SimpleAstronaut/Agent-Light/hardware/eda/PCB-Layout-RevA.md

# Agent Light Rev A PCB 布局布线初版

日期：2026-10-27。编辑器：嘉立创 EDA 专业版 4.1.78。

## 交付

- `Agent-Light-v1-layout.epro2`：包含五页原理图、依赖库和完成布局布线的 PCB1；导入嘉立创 EDA 专业版打开。
- `sources/PCB1.epcb`：PCB 原生文本源码备份，依赖库在工程包内。
- `previews/pcb-layout-final.png`：编辑器实际画布预览。
- `Agent-Light-RevA-DRAFT-Gerber.zip`：EDA 导出的制造初稿，含上下铜、丝印、阻焊、钢网、板框和钻孔。
- `Agent-Light-RevA-PickPlace-All.tsv`：EDA 原始坐标导出，包含所有 35 个位号。
- `Agent-Light-RevA-Assembly-PickPlace.csv`：装配坐标，排除 C3、R6 以及 TP1–TP8，共 25 个器件；搭配既有 BOM-RevA.csv 使用。
- `pcb-verification.json`：最终 PCB DRC 和图元数量记录。

## 实施结果

12 × 40 mm 双层板；顶层装配。USB-C 位于下端，红灯在上、黄灯在中、绿灯在下。35 个器件全部保留，包括 2 个 DNP 选配器件和 8 个不装排针的镀通孔测试焊盘。

ESD 位于接口之后，USB 串阻位于 MCU 前方。USB 主链路位于顶层；USB-C 重复 D− 焊盘连接采用 2 个过孔跨越，避免与重复 D+ 连接短接。其余电源、LED、复位、BOOT 和 SWD 网络均已连接。顶底层均有 GND 覆铜，已重建填充；局部接地补充过孔。保留原理图默认 R5 装配、R6/C3 不装规则。

最终编辑器 PCB DRC（严格模式）返回 `[]`：零报告错误、零未连接。最终统计：35 个器件、305 段直线走线、32 个过孔、2 个覆铜边框。Gerber 钻孔表最小孔径约 0.305 mm。

## 制造前必须解决的项目

**此版本是布局布线初版，制造包明确标记 DRAFT；尚未达到计划 WP31 的全部制造冻结要求。**

1. 板厚、板厂实际层叠和介电参数尚未冻结，USB 使用初版布线尺寸，未证明达到 90 Ω 差分阻抗，也未完成基于真实层叠的差分耦合/匹配优化。DRC 通过不代表阻抗通过。应在冻结层叠后调整 USB 几何并重新导出制造包。
2. USB-C 重复 D− 焊盘跨层，须纳入 USB 回流及信号完整性复核。底层亦有部分信号走线，地铜不是无切割的完整平面。
3. 部分局部接地过孔位于或接近 SMD 焊盘。首版手焊时控制焊料；如计划钢网回流装配，应先复核吸锡风险和塞孔/移孔方案。
4. 丝印已缩小，但密集区域仍需结合装配图查看位号。外壳遮光仓、USB-C 插拔空间和工装测试点可达性尚无结构模型验证。
5. 尚未执行第二人封装/极性审查、板厂 DFM、实物 bring-up、USB 枚举/热插拔或 ESD 测试；这些不在本次软件 DRC 的证明范围。

## USB 网络长度记录

以下为 EDA 各网络总走线长度，含连接器重复焊盘的分支，不等同于端到端差分路径长度。

| 网络 | mil |
|---|---:|
| USB_DP_CON | 293.957318 |
| USB_DM_CON | 358.253209 |
| USB_DP_ESD | 196.968934 |
| USB_DM_ESD | 96.194703 |
| USB_DP | 165.511008 |
| USB_DM | 173.534304 |

没有下单或上传制造资料到板厂。
