SimpleAstronaut/Agent-Light/shell/revision-2026-11-12/设计与检查记录.md

# Rev B 外壳设计与执行记录

用户已确认方案：打印底壳，Type-C 向上敞开 U 槽，PCB 从上方落入，透明亚克力平贴胶粘。

现有模型：44×16×13 mm，主腔40×12 mm，顶部定位唇内口42×14 mm；PCB STEP板框约39.975×11.975×1.600 mm，USB外伸1.367 mm。原装配体没有PCB实体。

方案比较：只放大内腔仍要求USB斜插；采用U槽消除侧孔上桥，便于垂直装配（用户选定）；重新拆分侧墙增加零件和接缝，本次不采用。

实施尺寸由设计者选取：内腔41.2×13.2 mm（每边约0.6 mm余量），外形保留44×16×13 mm；U槽宽11 mm，从既有孔底接通至顶；支撑横筋中部下凹1 mm保留两侧支承；透明板44×16×2 mm，平贴顶沿。胶层暂按0.15 mm装配示意，实际厚度及材料由加工试片确认。

执行计划：
- [x] 复制所有原始模型到revision-2026-11-12，另存底壳-RevB。
- [x] 在原生副本追加内腔扩容、USB敞口、焊点避让特征，导出STEP/STL。
- [x] 建立亚克力盖模型与1:1 DXF，制作含PCB的独立检查装配。
- [x] 以精确几何检查原始/修改壳的静态干涉与垂直装配路径，保存结果。
- [x] 检查文件存在、重新读回几何有效性、原始文件哈希不变，交付说明。

验证边界：STEP不包含手焊焊料；不能用数字干涉通过代替实物试装；未指定打印材料、设备、实板外形测量和胶水，留作样件验证事项。不改PCB，不下单。
