SimpleAstronaut/Agent-Light/docs/superpowers/plans/2026-10-28-firmware.md

# Agent Light FreeRTOS Firmware Implementation Plan

> **For agentic workers:** Use superpowers:executing-plans to implement this plan task-by-task. Steps use checkbox syntax for tracking.

**Goal:** 为已完成的 STM32F042F6P6 Rev A PCB 实现可构建、可测试的 FreeRTOS USB CDC 固件。

**Architecture:** PC 是业务状态唯一权威。固件使用静态 FreeRTOS 任务和缓冲，USB ISR 仅处理 USB 栈和收发队列；单任务管理协议、显示和链路超时，避免共享状态竞争。

**Tech Stack:** C11、STM32CubeF0 HAL/USB、FreeRTOS、ARM GCC；提供 MDK 工程与 CubeMX 配置说明。

**Spec:** outputs/agent-indicator-execution-plan.md §8、§15；hardware/eda/README.md。

## Global Constraints

- STM32F042F6P6，Flash 32 KB、RAM 6 KB。
- PA9/PA10 重映射 USB PA11/PA12；HSI48 + CRS；PA0/1/2 AF2 TIM2_CH1/2/3，10 kHz。
- 协议 v1、payload ≤32、COBS + CRC16-CCITT-FALSE、20–100% 亮度、默认 35%、5 秒看门狗。
- 中文注释；采用 Google C++ 指南中适用 C 的命名、缩进、头文件防护和函数契约说明，厂商文件不改风格。
- 仅 SWD；不写配置 Flash。实物验收和 Cube/Keil GUI 首次确认仍按原计划交给用户。

## Review Focus

- USB 分包/粘包/队列溢出后的完整帧恢复。
- 同 seq 不同请求、重试和 revision 回绕。
- 超时后重试同 revision 必须重新进入 ACTIVE；心跳不能恢复旧灯态。
- USB reset/suspend/resume 与待发送 ACK 的代次隔离。
- RAM/任务栈/USB 分配、ISR 和调度器启动顺序。

### Task 1: 协议和显示核心

**Files:** firmware/app/{crc16,cobs,display,protocol}.c/.h；firmware/tests/host/test_main.c。
**Interfaces:** ProtocolFeed / ProtocolReset / ProtocolPoll / DisplayGetLeds；核心不依赖 HAL/RTOS。

- [x] 写主机测试，观察缺少实现时失败。
- [x] 实现帧校验、NACK、单事务去重、revision、模式和灯效。
- [x] gcc 严格警告构建并通过测试；补独立 Python golden vectors。

### Task 2: 板级和 FreeRTOS USB 集成

**Files:** firmware/Core、firmware/USB_Device、firmware/app/app_main.c、firmware/build.ps1、链接脚本。
**Interfaces:** USB RX 有界队列；SerialTx 单一发送入口；AppUsbEvent 使总线事件先于字节处理。

- [x] 固定 STM32CubeF0 官方 tag 和子模块 SHA，记录工具链。
- [x] 接入静态任务、10 kHz PWM、HSI48/CRS、USB CDC、静态 USB 类存储。
- [x] 构建 Debug/Release，检查 map 和栈预算，输出 ELF/HEX/BIN/hash。

### Task 3: 工程和验收交付

**Files:** firmware/README.md、firmware/docs、firmware/MDK-ARM、contracts/usb-protocol-v1.md、firmware/tools。

- [x] 提供精确 CubeMX 配置、MDK 工程、版本表和 SWD/HIL 步骤。
- [x] 执行完整主机测试、两个目标配置构建和独立审查。
- [x] 记录实测结果和未执行的 GUI/硬件门禁。

## 执行记录

- 目录不是 Git 仓库，直接在用户指定目录新增 firmware/、contracts/ 和文档，不移动硬件文件，不创建额外 worktree。
- 用户已授权按现有设计和计划开发；以上是 WP30 的执行拆分，直接推进。
- 完成：主机核心及真实Setup入口测试通过，17组向量一致；最终Debug/Release Flash24324/20044B，静态RAM5356/5344B，MSP784/800B。产物一致性和中断向量校验通过。
- 独立审查发现CDC控制请求越界和配置前空指针路径，修复后追加入口级回归；另修复PWM重复启动和USB供电描述符。
- 未执行：Keil首次GUI构建、SWD烧录、实际USB/电气/长稳。仅找到蓝牙串口。详见firmware/docs/verification.md，不将这些标为通过。
