SimpleAstronaut/Agent-Light/docs/superpowers/plans/2026-11-06-pc-dsh.md

# PC + DSH implementation plan

Goal: implement the approved local HTTP → SQLite FSM → USB service and DSH Host observer with durable worker reporting, using the November 6 design and frozen USB v1.

Execution: inline in the supplied non-Git directory. User requests minimal review/testing: omit independent reviewers, repeated approval, broad performance/fault campaigns and commits. Preserve focused protocol/FSM/outbox checks and build checks.

- [x] Shared strict event schema, scoped producer/runtime/instance identity and source capability manifest.
- [x] Python PC service: transactional inbox/FSM/display, HTTP authentication, CLI configuration, process lock and single serial worker.
- [x] TypeScript plugin: version gate, root-only lifecycle, approval/question pairing, bounded reporter, durable outbox Worker.
- [x] Build, focused smoke checks, deployment overlay and operational documentation. Live DSH profile was not modified.

Verification limits: real Web answerer ordering, hardware E2E, kill-at-each-fsync and performance percentiles require separate evidence; capabilities remain unverified until then. No real Codex adapter is claimed.

Result: PC 5 focused checks pass, plugin 4 focused checks pass. Installed Cordis global/prepend probe passes. Synthetic root lifecycle through Cordis → durable Worker → real PC HTTP/SQLite reaches RUNNING → ATTENTION → COMPLETED. Python wheel and npm tarball are in outputs/packages. See outputs/pc-dsh-implementation.md for the delivery record.
