SimpleAstronaut/Agent-Light/hardware/eda/previews/contact-sheet.png

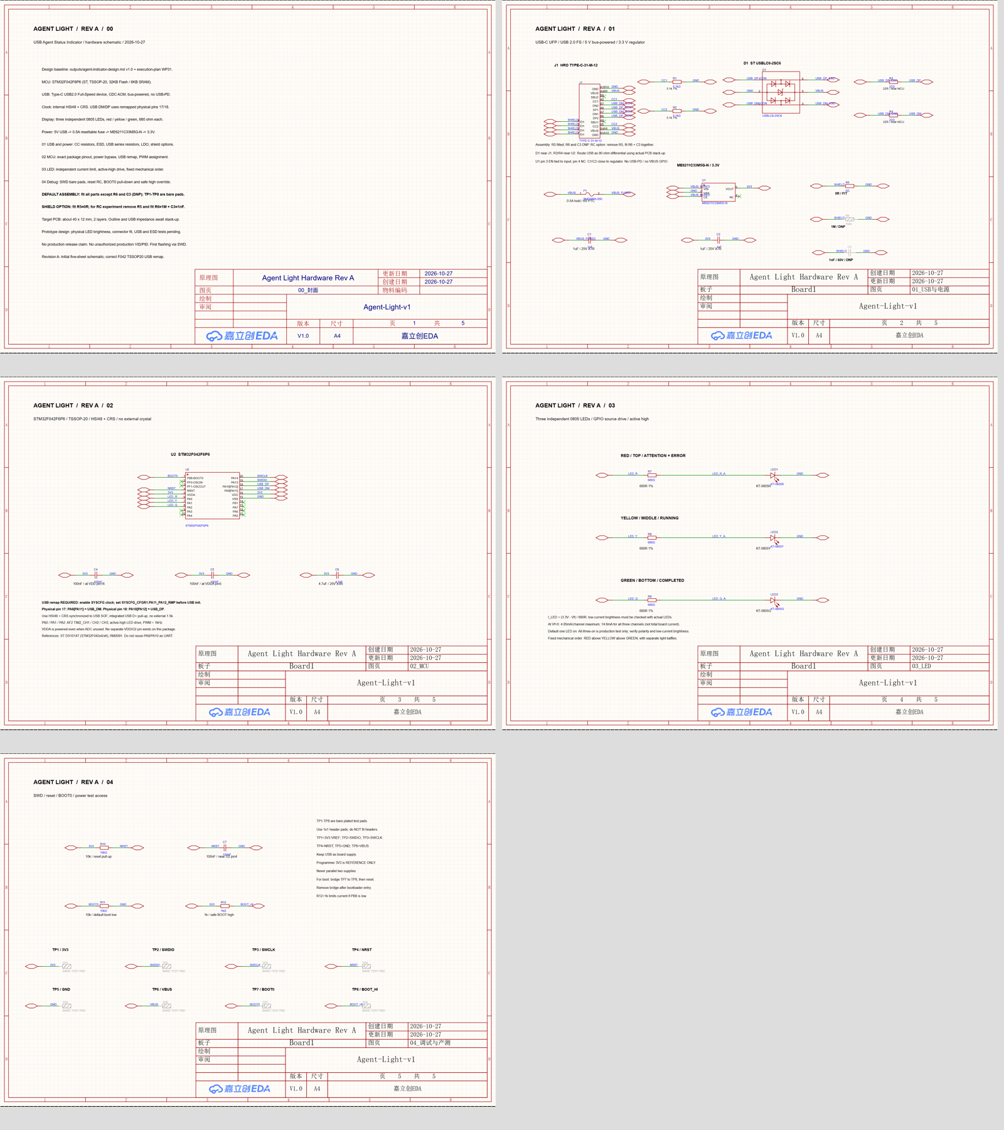
hardware/eda/previews/contact-sheet.png
