SimpleAstronaut/Agent-Light/hardware/eda/previews/pcb-layout-final.png

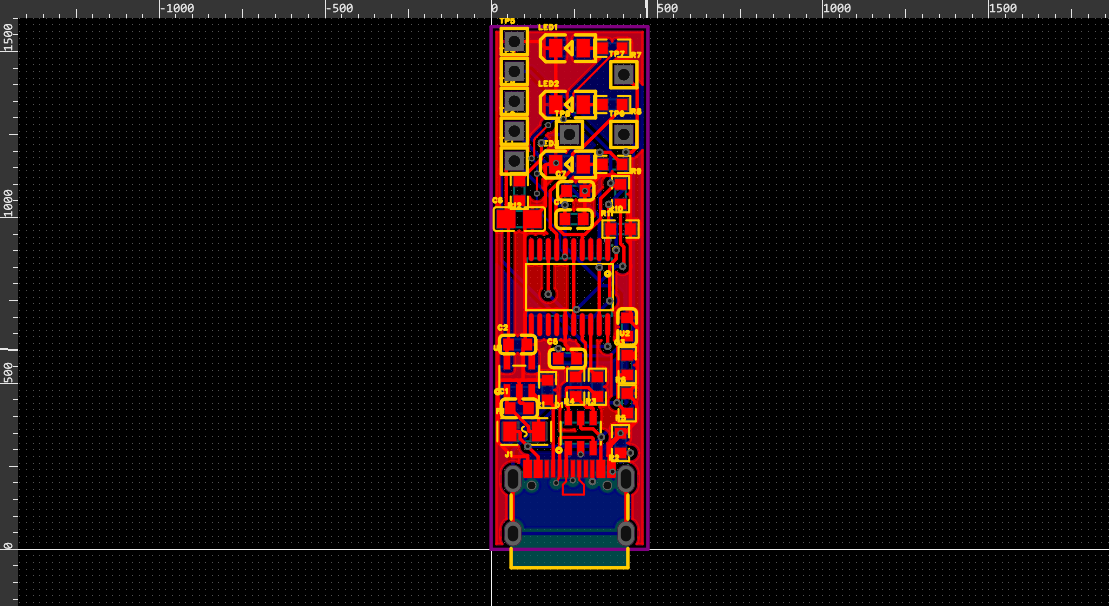
hardware/eda/previews/pcb-layout-final.png
