SimpleAstronaut/Agent-Light/hardware/eda/previews/SCH_Agent Light Hardware Rev A_1-00_封面_2026-10-27.png

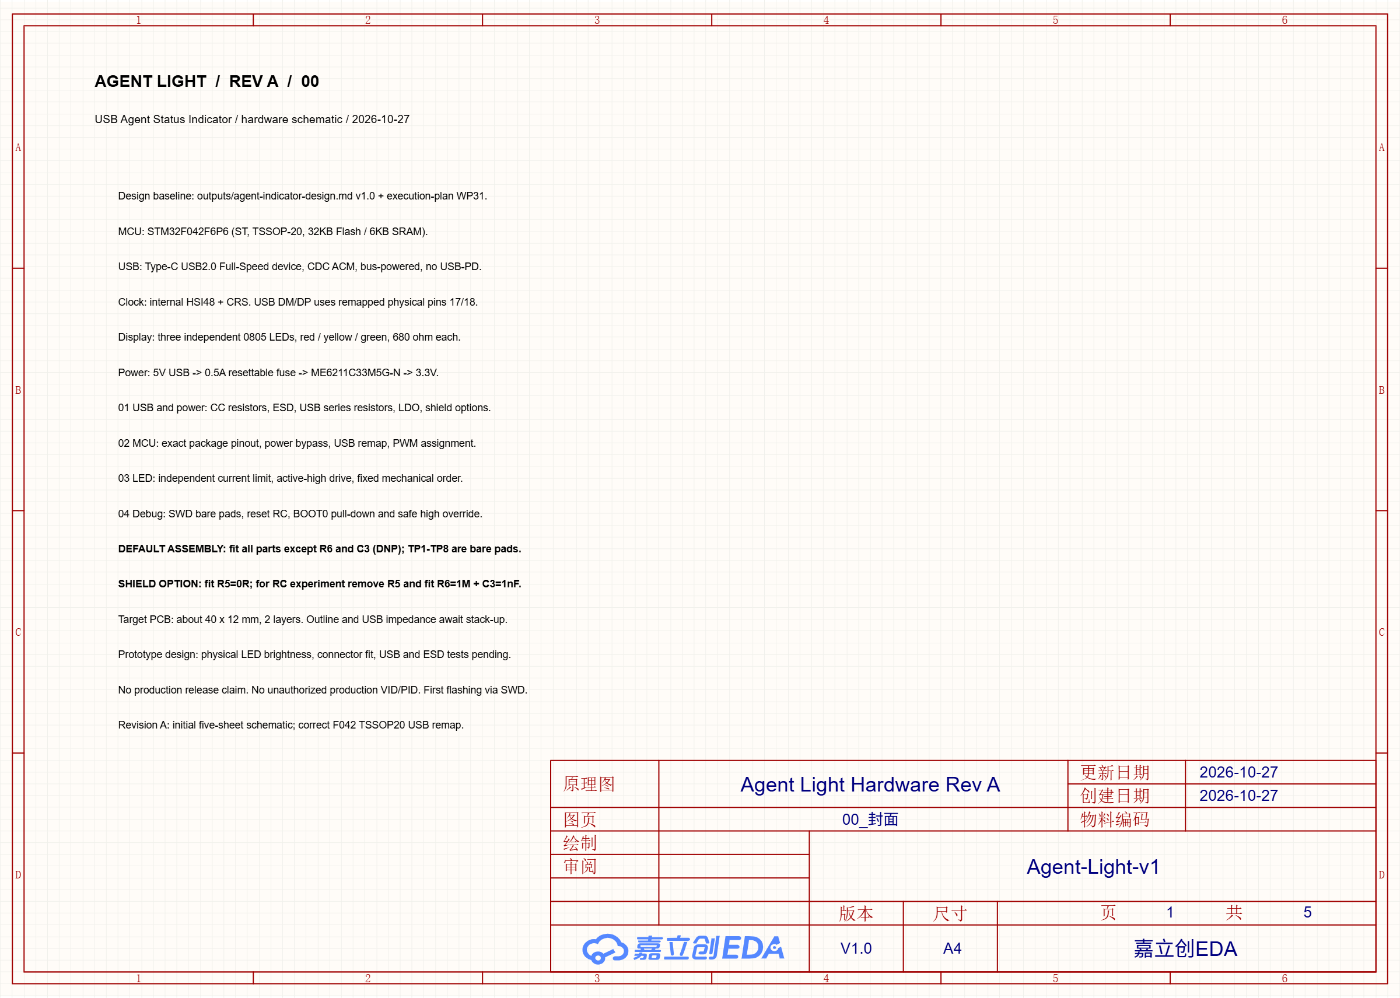
hardware/eda/previews/SCH_Agent Light Hardware Rev A_1-00_封面_2026-10-27.png
