SimpleAstronaut/Agent-Light/hardware/eda/previews/SCH_Agent Light Hardware Rev A_2-01_USB与电源_2026-10-27.png

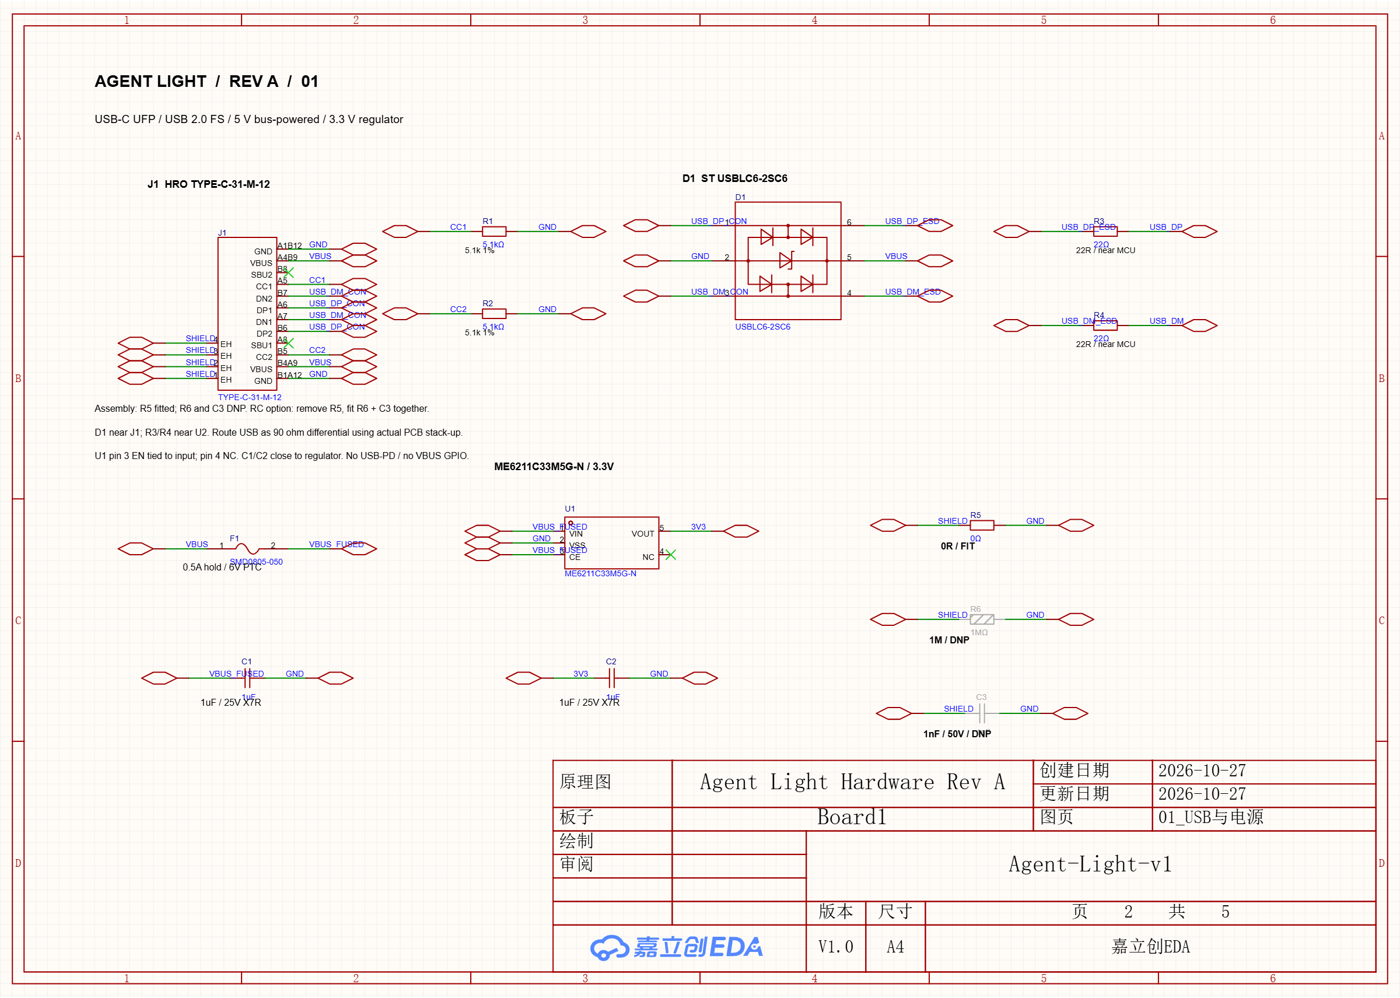
hardware/eda/previews/SCH_Agent Light Hardware Rev A_2-01_USB与电源_2026-10-27.png
