SimpleAstronaut/Agent-Light/hardware/eda/previews/SCH_Agent Light Hardware Rev A_3-02_MCU_2026-10-27.png

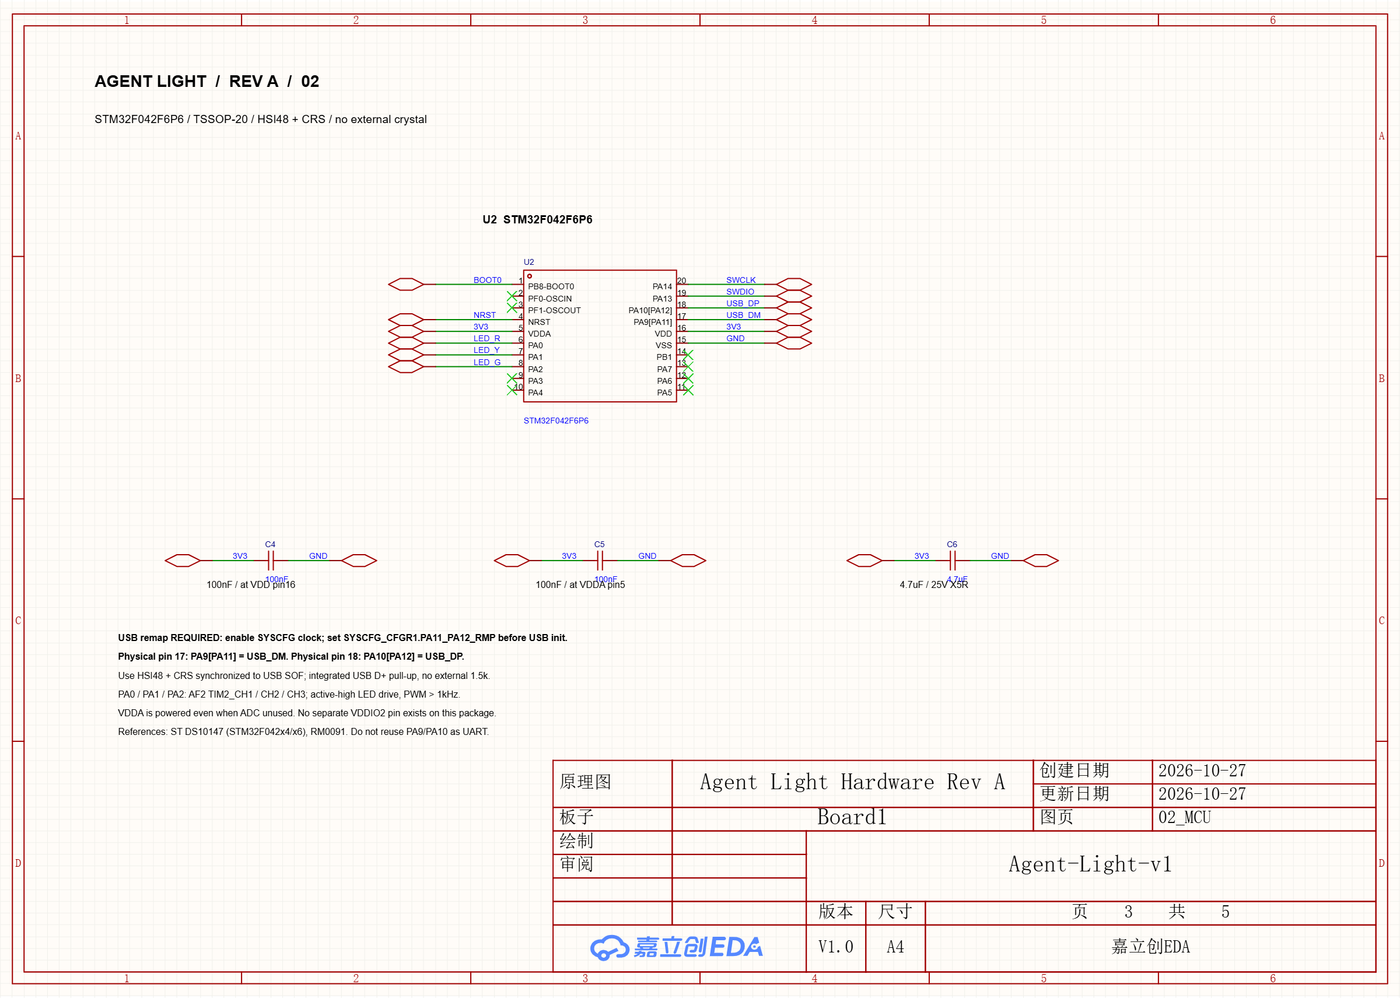
hardware/eda/previews/SCH_Agent Light Hardware Rev A_3-02_MCU_2026-10-27.png
