SimpleAstronaut/Agent-Light/hardware/eda/previews/SCH_Agent Light Hardware Rev A_4-03_LED_2026-10-27.png

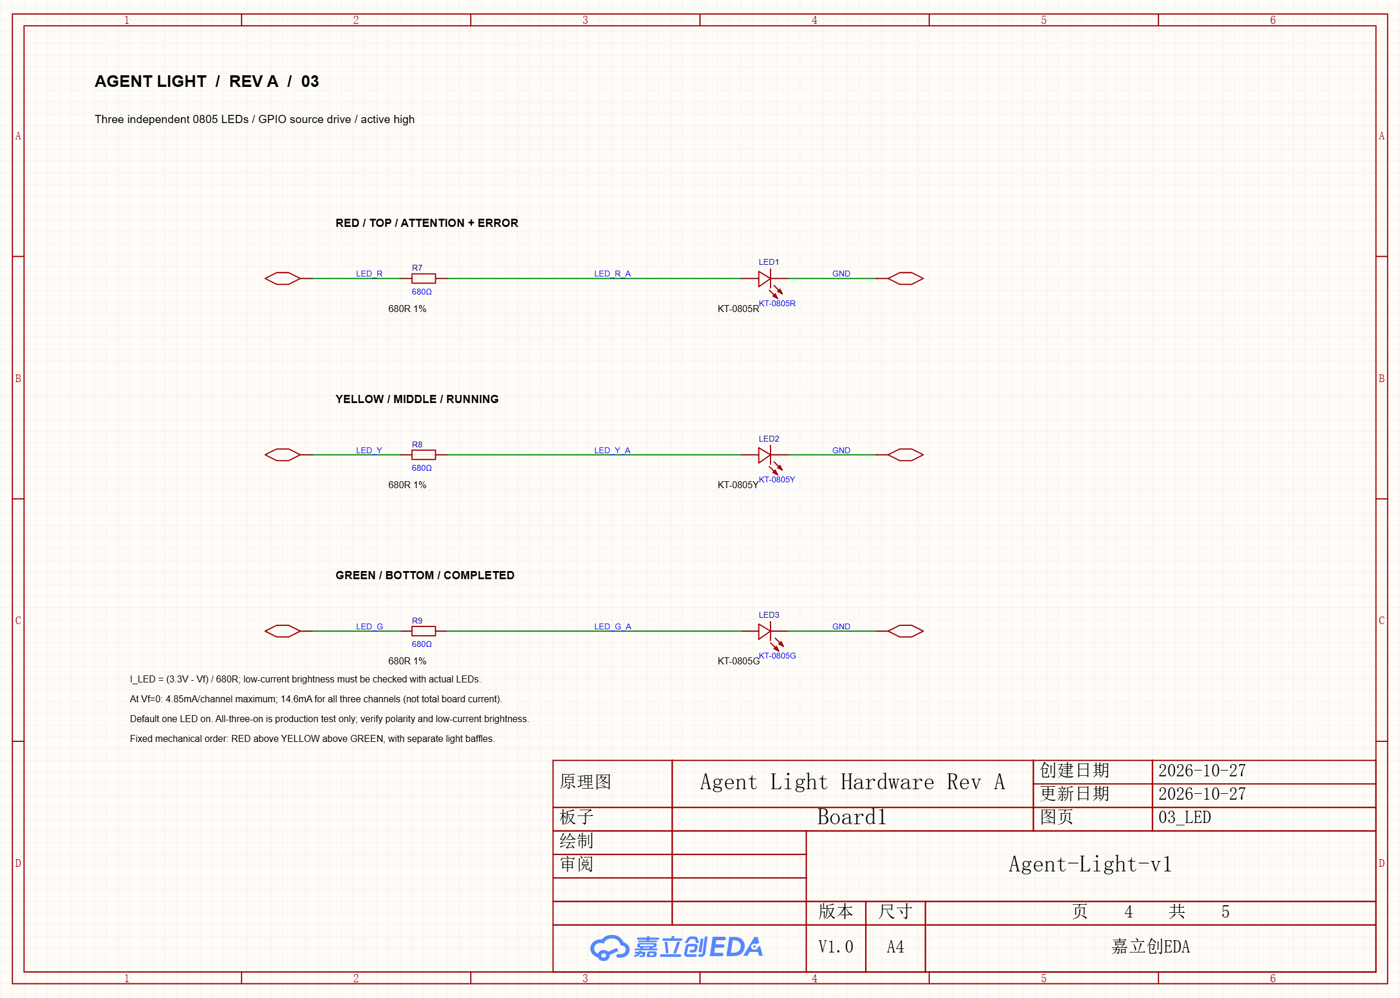
hardware/eda/previews/SCH_Agent Light Hardware Rev A_4-03_LED_2026-10-27.png
