SimpleAstronaut/Agent-Light/outputs/agent-integrations-dsh-preview.png

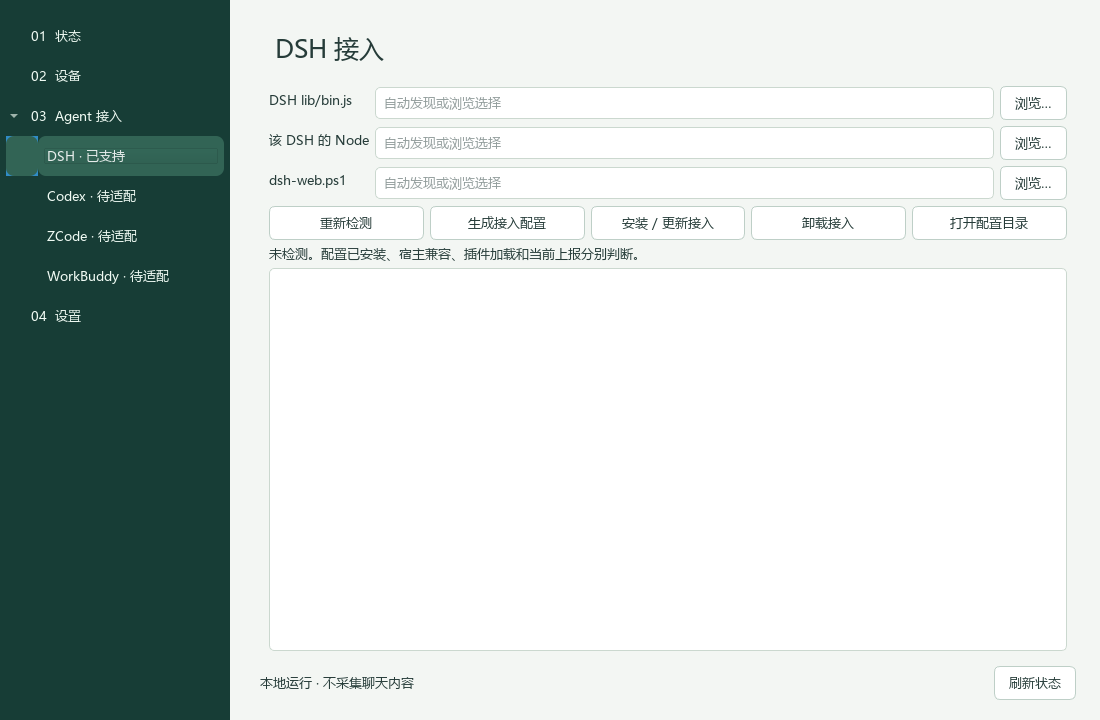
outputs/agent-integrations-dsh-preview.png
