SimpleAstronaut/Agent-Light/outputs/desktop-preview.png

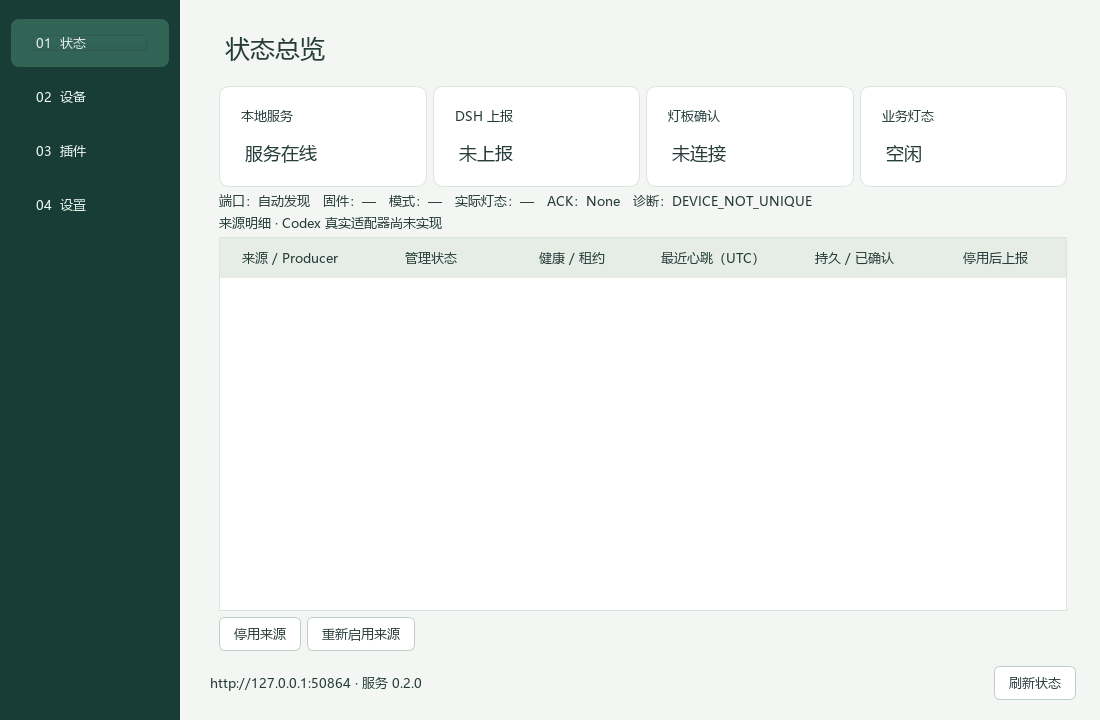
outputs/desktop-preview.png
