SimpleAstronaut/Agent-Light/shell/revision-2026-11-12/previews/RevB-open.png

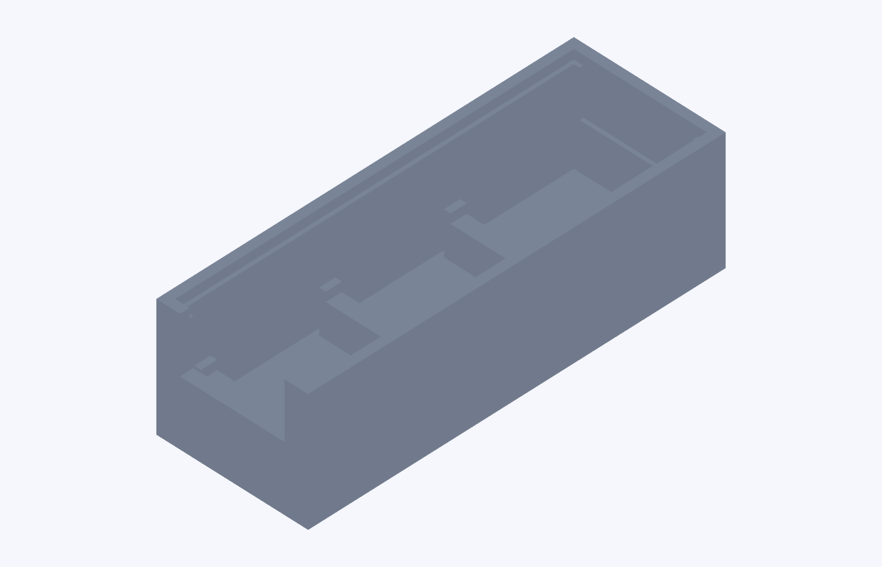
shell/revision-2026-11-12/previews/RevB-open.png
