SimpleAstronaut/Agent-Light/shell/revision-2026-11-12/零件1.STEP

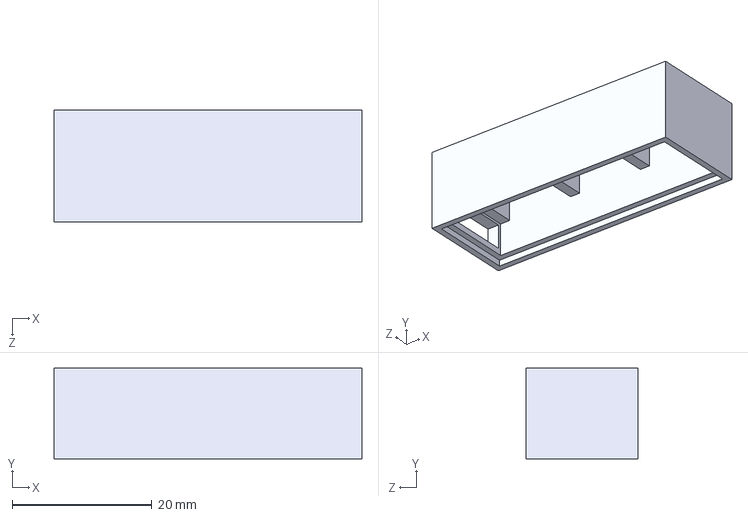
[picture p12: CAD file, 2026-11-12]
shell/revision-2026-11-12/零件1.STEP
44.0 x 13.0 x 16.0 mm
