SimpleAstronaut/Agent-Light/shell/revision-2026-11-12/底壳-RevB-调整坐标前.SLDPRT

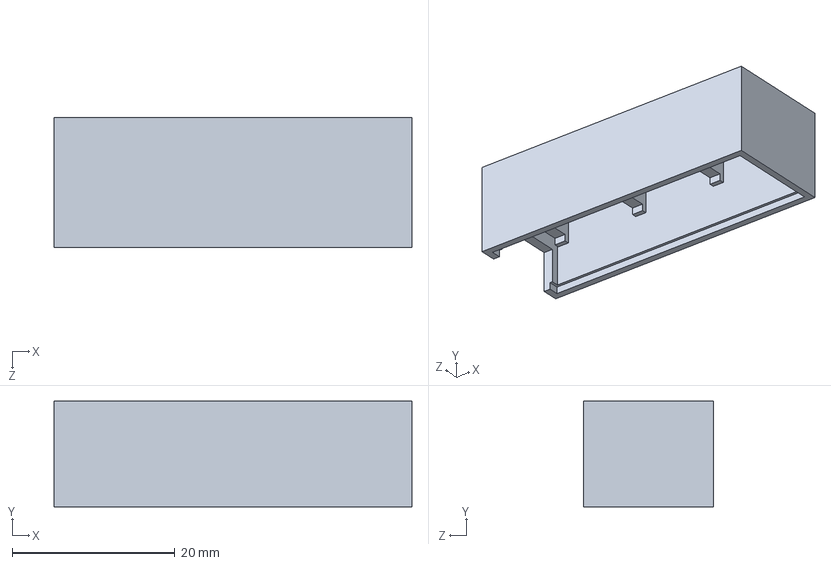
[picture p13: CAD file, 2026-11-12]
shell/revision-2026-11-12/底壳-RevB-调整坐标前.SLDPRT
44.0 x 13.0 x 16.0 mm
