SimpleAstronaut/Agent-Light/shell/顶盖.SLDPRT

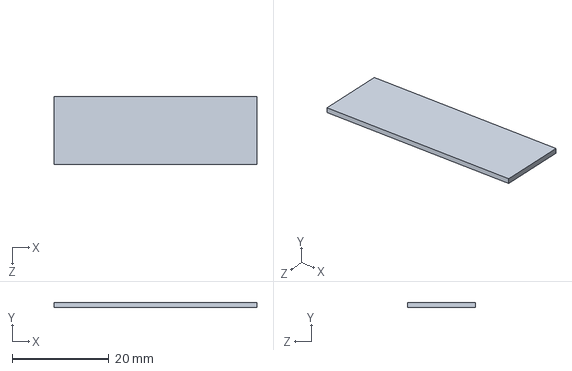
[picture p14: CAD file, 2026-11-12]
shell/顶盖.SLDPRT
42.0 x 1.00 x 14.0 mm
