SimpleAstronaut/Agent-Light/shell/3D_PCB1_2026-11-11.step

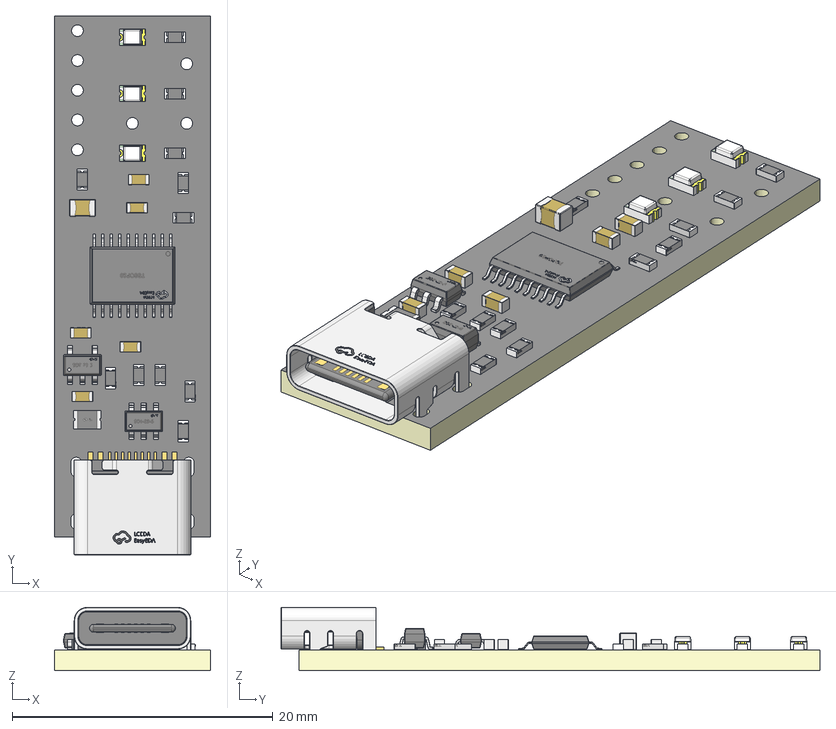
[picture p15: CAD file, 2026-11-12]
shell/3D_PCB1_2026-11-11.step
12.0 x 41.4 x 4.85 mm
Board~ZX35
TopCopper~ZX35
BottomCopper~ZX35
TopSilkscreen~ZX35
BottomSilkscreen~ZX35
TopFpcStiffener~ZX35
BottomFpcStiffener~ZX35
F0805~F0805_L2.1-W1.4-H0.8~oxM3
C0805~C0805_L2.0-W1.3-H1.3~TfBH
R0603~R0603~3T9n x 11
LED0805-R-RD~LED0805-RD~cnoO x 3
C0603~C0603_L1.6-W0.8-H0.8~Q8ED x 5
USB-C_SMD-TYPE-C-31-M-12_1~USB-C_SMD-TYPE-C-31-M-12_1~IsrO
SOT-23-5_L3.0-W1.7-P0.95-LS2.8-BL~SOT-23-5_L2.9-W1.6-H1.1-LS2.8-P0.95~IIpx
SOT-23-6_L2.9-W1.6-P0.95-LS2.8-BL~SOT-23-6_L2.9-W1.6-H1.5-LS2.8-P0.95~w8YE
TSSOP-20_L6.5-W4.4-P0.65-LS6.4-BL~TSSOP-20_L6.5-W4.4-H1.0-LS6.4-P0.65~XDhw
