SimpleAstronaut/Agent-Light/shell/revision-2026-11-12/亚克力顶盖-44x16-切割.dxf

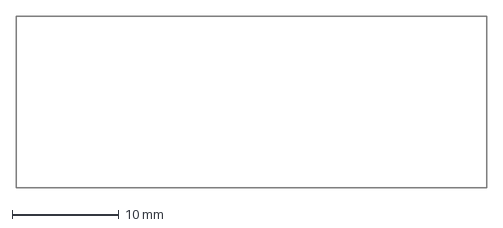
[picture p16: CAD file, 2026-11-12]
shell/revision-2026-11-12/亚克力顶盖-44x16-切割.dxf
44.0 x 16.0 mm
