SimpleAstronaut/Agent-Light/shell/revision-2026-11-12/亚克力顶盖-44x16x2.step

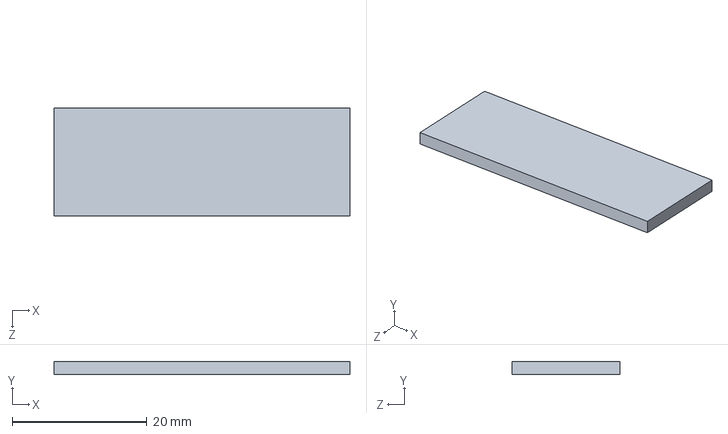
[picture p17: CAD file, 2026-11-12]
shell/revision-2026-11-12/亚克力顶盖-44x16x2.step
44.0 x 2.00 x 16.0 mm
