SimpleAstronaut/Agent-Light/shell/shell.SLDASM

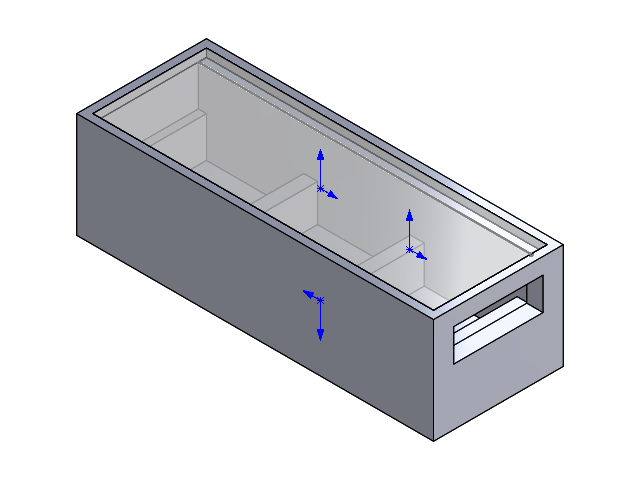
[picture p18: CAD file, 2026-11-12]
shell/shell.SLDASM
零件1
零件1^shell
零件2^shell
顶盖
