SimpleAstronaut/Agent-Light/(list of files, cad)

Other CAD files:
shell/revision-2026-11-12/底壳-RevB.step
shell/revision-2026-11-12/底壳-RevB-平底打印.stl
shell/revision-2026-11-12/原底壳-对照.step
shell/revision-2026-11-12/亚克力顶盖-44x16x2.SLDPRT
shell/revision-2026-11-12/底壳-RevB.SLDPRT
shell/revision-2026-11-12/零件1.SLDPRT
shell/零件1.SLDPRT
