SimpleAstronaut/Agent-Light/hardware/eda/previews/SCH_Agent Light Hardware Rev A_5-04_调试与产测_2026-10-27.png

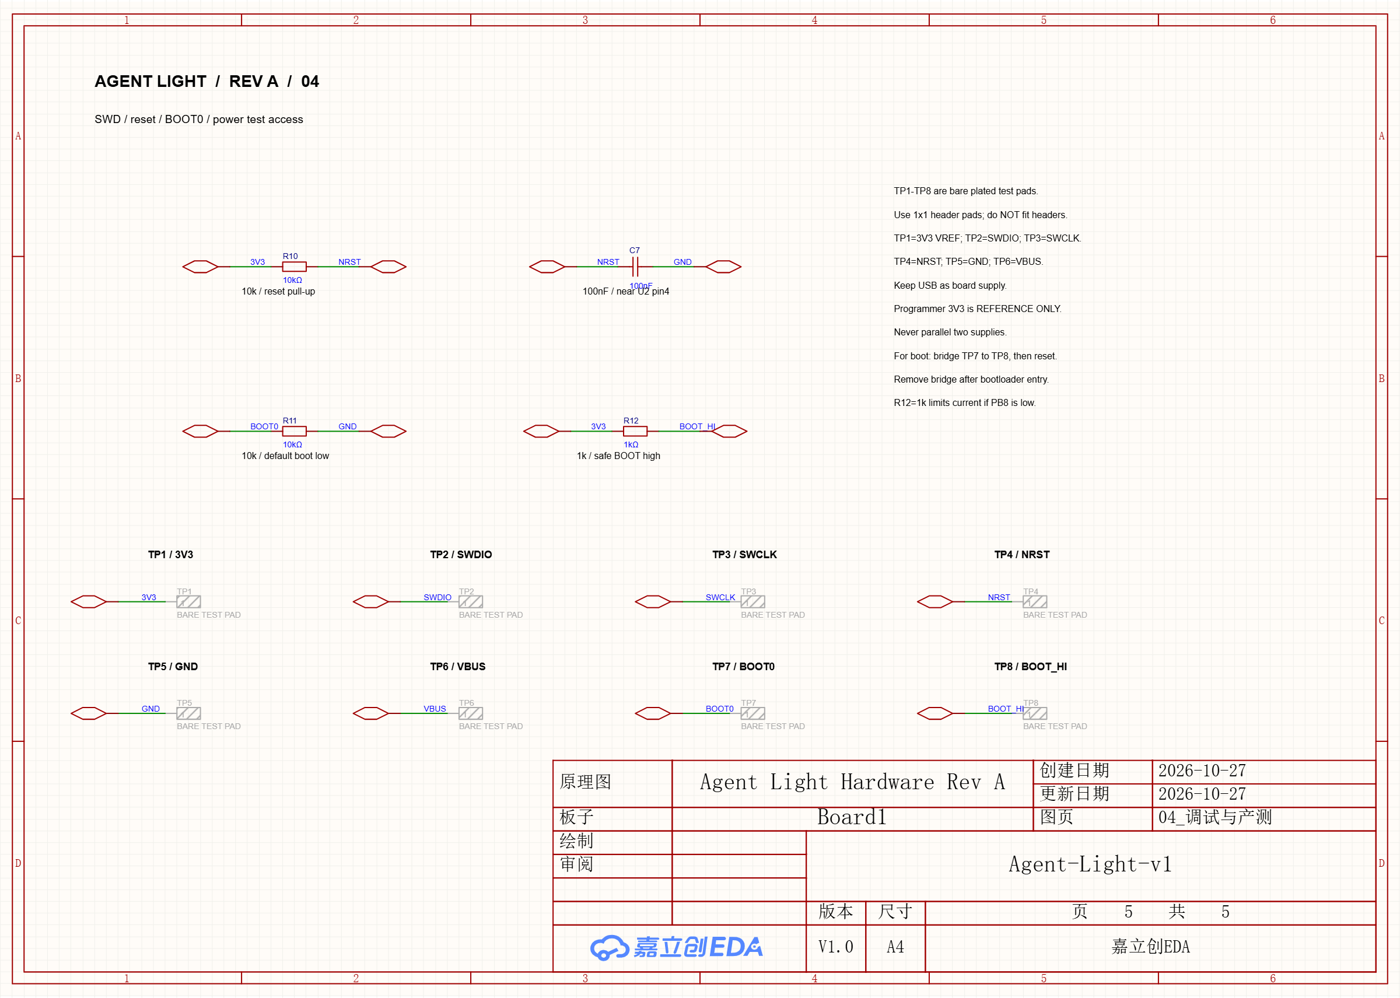
hardware/eda/previews/SCH_Agent Light Hardware Rev A_5-04_调试与产测_2026-10-27.png
