SimpleAstronaut/Agent-Light/(list of files, drawings)

Other design files:
hardware/eda/pcb-verification.json
