SimpleAstronaut/Agent-Light/firmware/cubemx/agent_light_peripherals.ioc

Mcu.UserName=STM32F042F6Px
PA0.GPIO_Label=LED_RED
PA0.Signal=S_TIM2_CH1_ETR
PA1.GPIO_Label=LED_YELLOW
PA1.Signal=S_TIM2_CH2
PA11.Signal=USB_DM
PA12.Signal=USB_DP
PA13.Signal=SYS_SWDIO
PA14.Signal=SYS_SWCLK
PA2.GPIO_Label=LED_GREEN
PA2.Signal=S_TIM2_CH3
