SimpleAstronaut/Agent-Light/pc/agent_light/locking.py

import os


class ProcessLock:
    def __init__(self, path):
        self.file = open(path, "a+b")
        self.file.seek(0)
        self.file.write(b"0")
        self.file.flush()
        self.file.seek(0)
        try:
            if os.name == "nt":
                import msvcrt
                msvcrt.locking(self.file.fileno(), msvcrt.LK_NBLCK, 1)
            else:
                import fcntl
                fcntl.flock(self.file, fcntl.LOCK_EX | fcntl.LOCK_NB)
        except OSError:
            self.file.close()
            raise RuntimeError("SERVICE_ALREADY_RUNNING") from None

    def close(self):
        self.file.close()
