SimpleAstronaut/Agent-Light/(commit log)

2026-11-06 Initial open-source release of Agent Light
    [Agent-Light-RevA-Assembly-PickPlace.csv, Agent-Light-RevA-PickPlace-All.tsv, BOM-RevA.csv, pcb-verification.json]
2026-11-12 Fix PCB enclosure fit and add acrylic lid manufacturing files
    Add Rev B SolidWorks models with assembly clearance, top-loading USB slot,
    solder relief and default +Y opening orientation. Include validated bed-oriented
    STL, acrylic DXF, original CAD backups and reproducible geometry checks.
    [3D_PCB1_2026-11-11.step, shell.SLDASM, 亚克力顶盖-44x16-切割.dxf, 亚克力顶盖-44x16x2.SLDPRT, 亚克力顶盖-44x16x2.step, 原底壳-对照.step, 底壳-RevB-平底打印.stl, 底壳-RevB-调整坐标前.SLDPRT]
