SimpleAstronaut/Agent-Light/(notices)

Notices in the files:
README.md:
License: MIT
